coriolan-v/Mycelium-driver/Hardware/PCB/NEST Mushroom PCB Mk.1 pinout.pdf

# Mk.I NEST MAY 2023

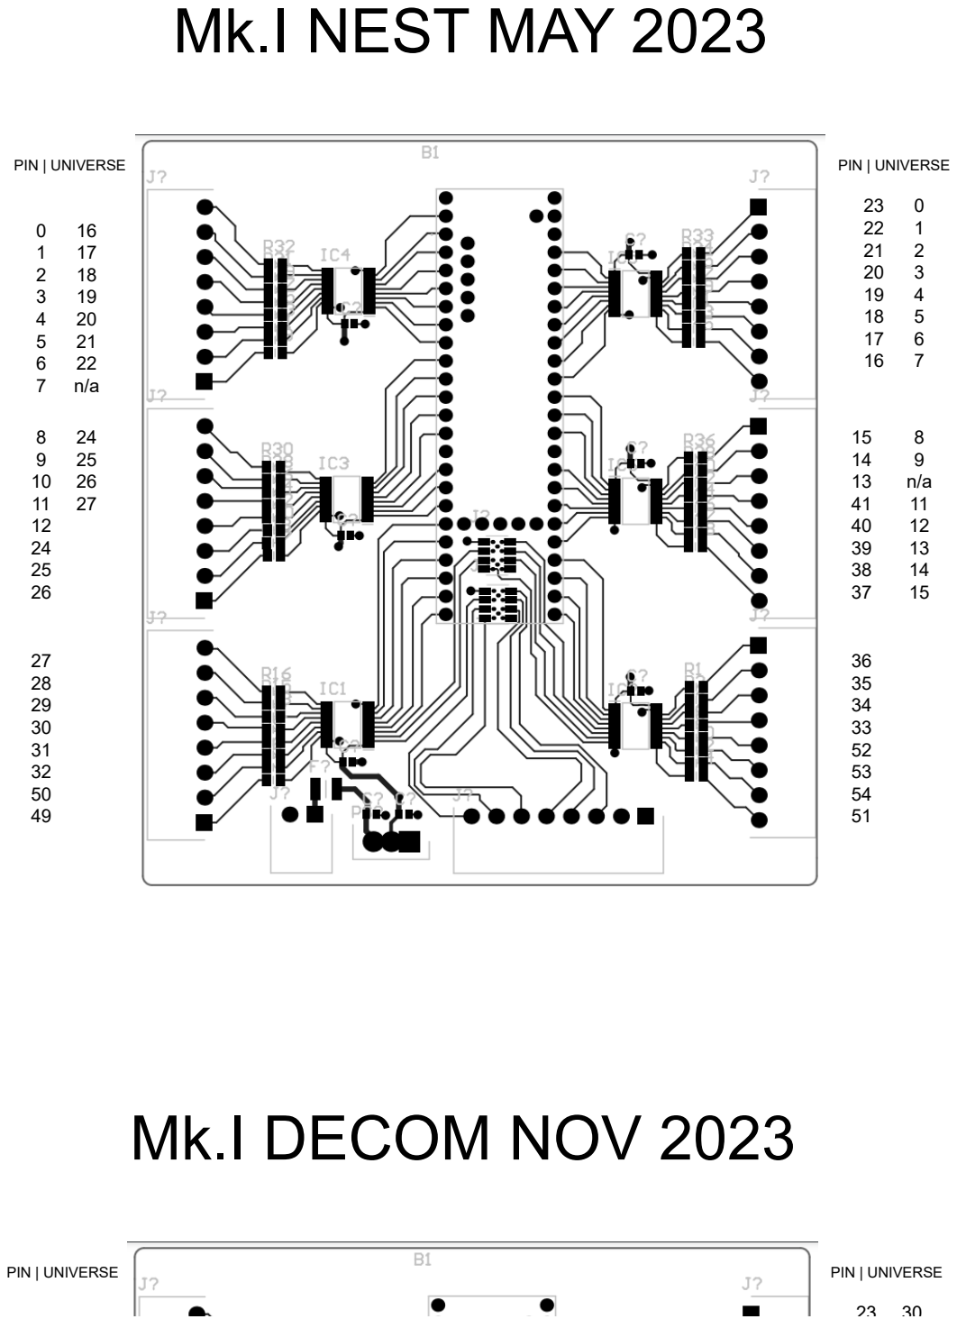
[picture p3: page 1]

PIN | UNIVERSE

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
PIN | UNIVERSE
PIN | UNIVERSE

23 30

PIN | UNIVERSE

# Mk.I DECOM NOV 2023

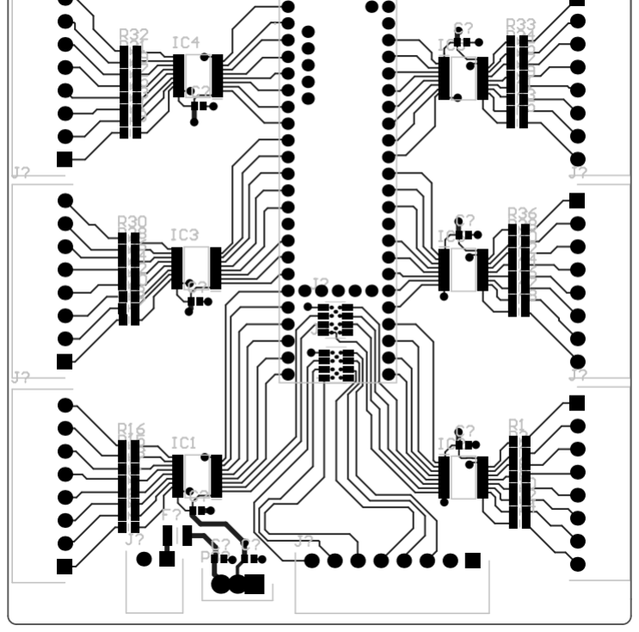
[picture p4: figure]

0123456789

1011

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
0123456789

1011

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
