coriolan-v/Mycelium-driver/Hardware/holder-1.stl

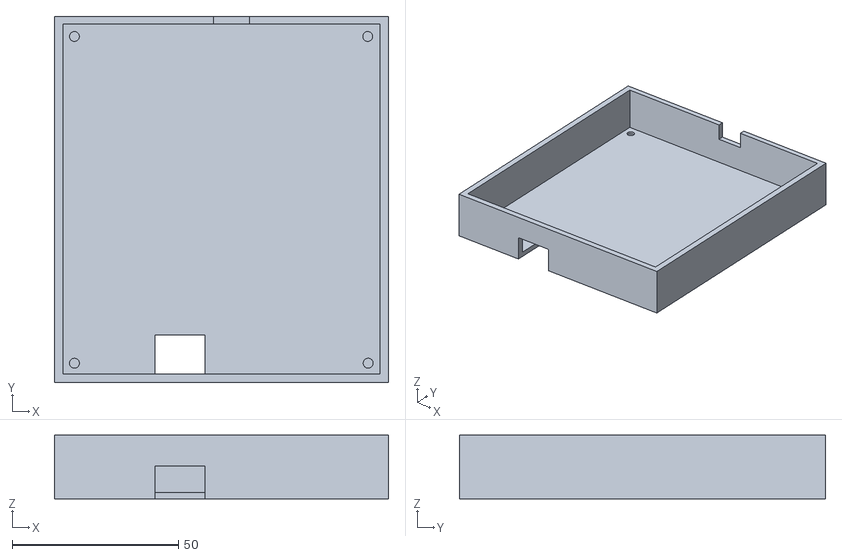
[picture p5: CAD file, 2026-06-23]
Hardware/holder-1.stl
100.7 x 110.2 x 19.2
