coriolan-v/Mycelium-driver/Hardware/cap-2.stl

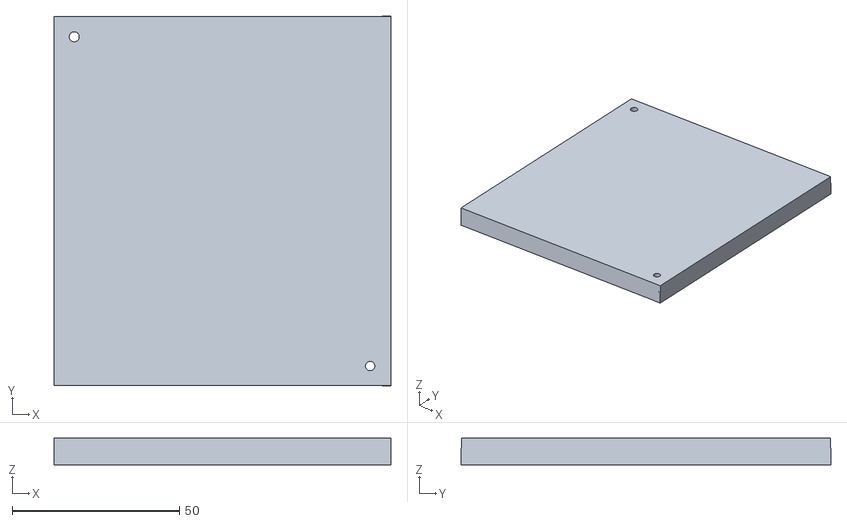
[picture p6: CAD file, 2026-06-23]
Hardware/cap-2.stl
100.7 x 110.5 x 7.98
