coriolan-v/Mycelium-driver/Hardware/cap-1.stl

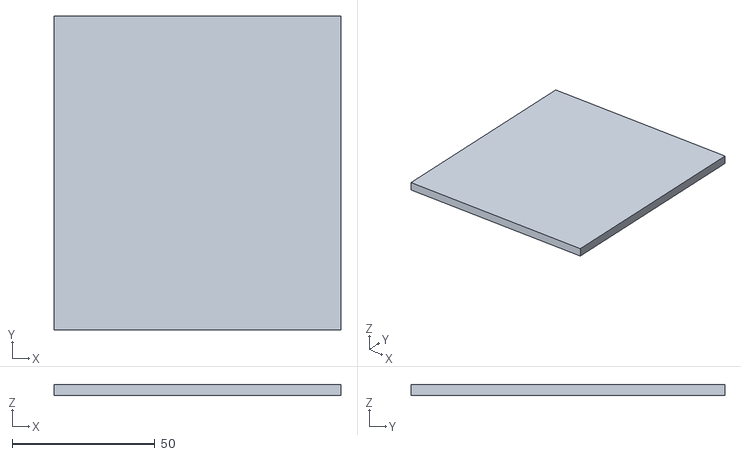
[picture p7: CAD file, 2026-06-23]
Hardware/cap-1.stl
100.7 x 110.2 x 4.00
