coriolan-v/Mycelium-driver/Hardware/holder-2.stl

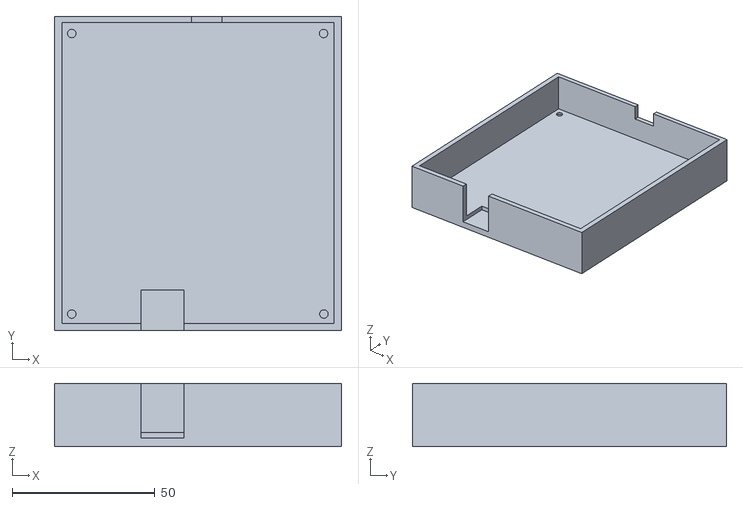
[picture p8: CAD file, 2026-06-23]
Hardware/holder-2.stl
100.7 x 110.2 x 22.2
