coriolan-v/Mycelium-driver/Hardware/PCB/pcb-outline.pdf

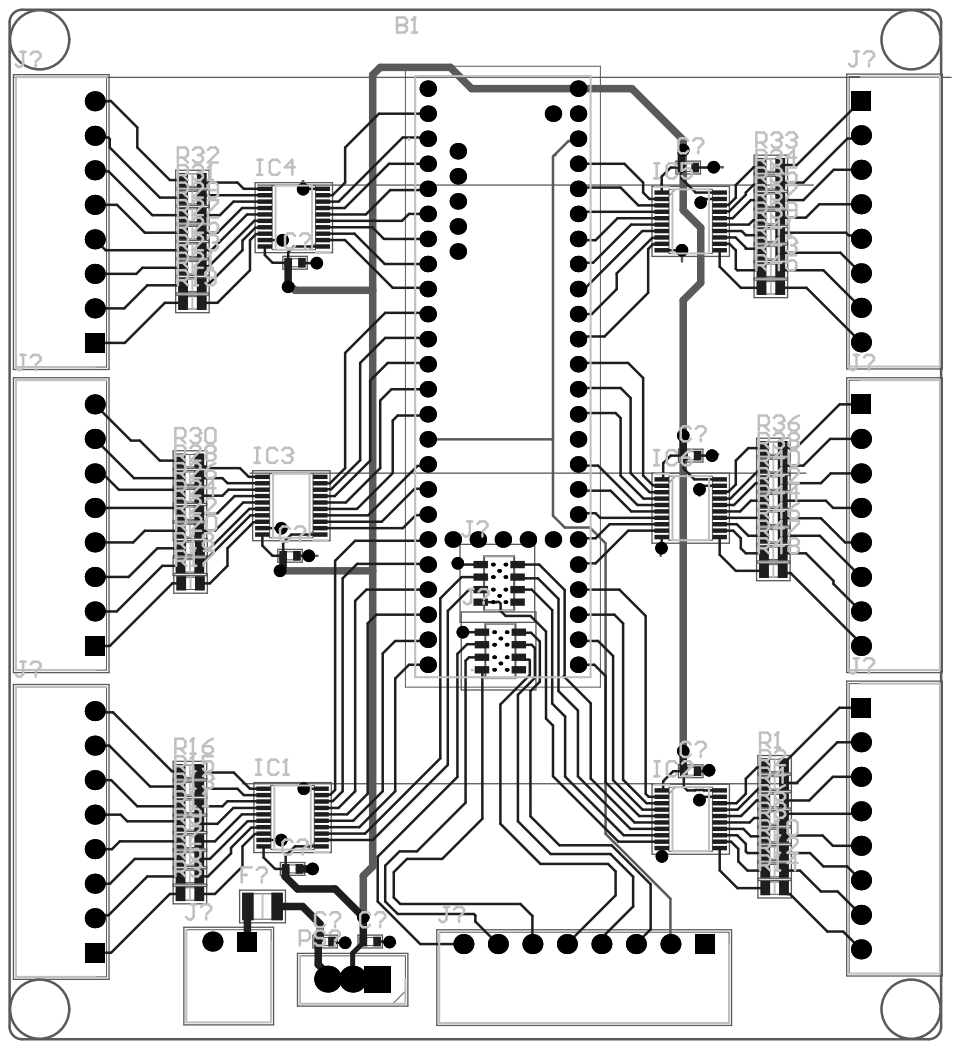
[picture p9: page 1]
