coriolan-v/Mycelium-driver/Hardware/PCB/Nest-Distrib-Mk.I/Nest-Distrib-MkI-Layout.pdf

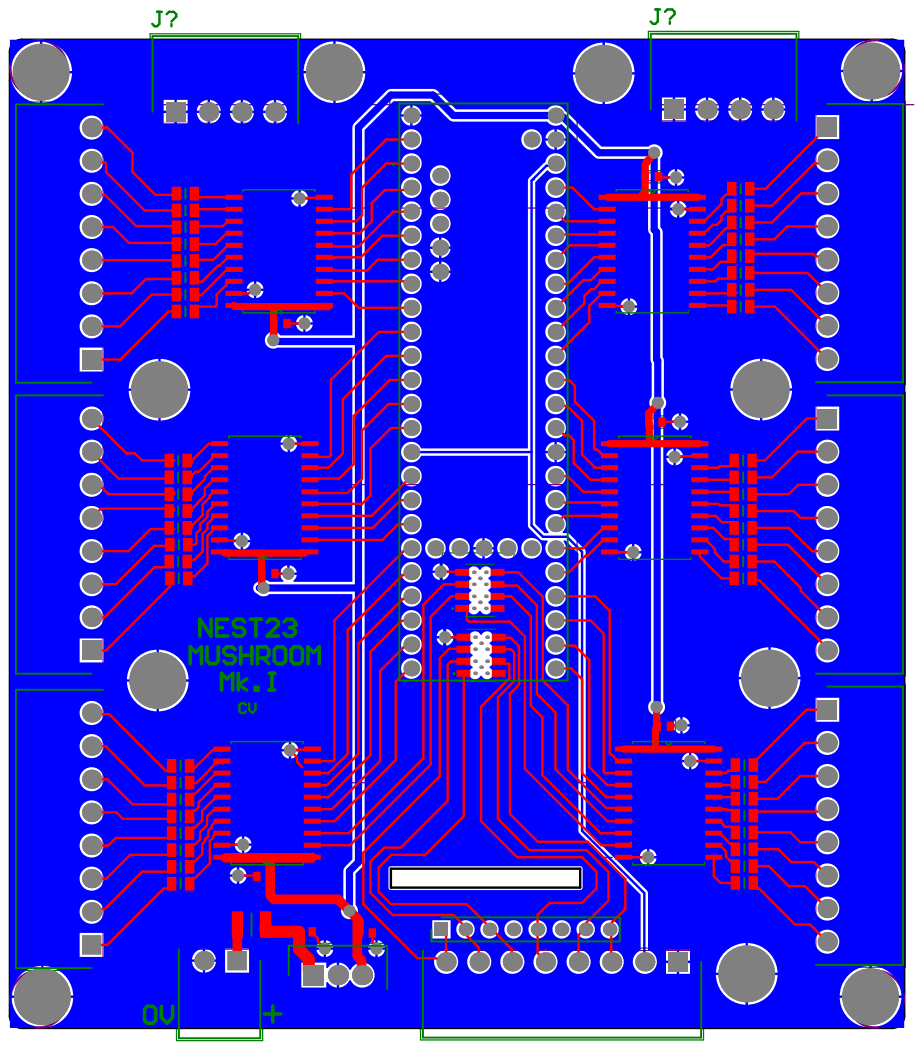
[picture p10: page 1]
