coriolan-v/Mycelium-driver/Hardware/PCB/Nest-Distrib-Mk.I/Nest-Distrib-MkI-Schematic.pdf

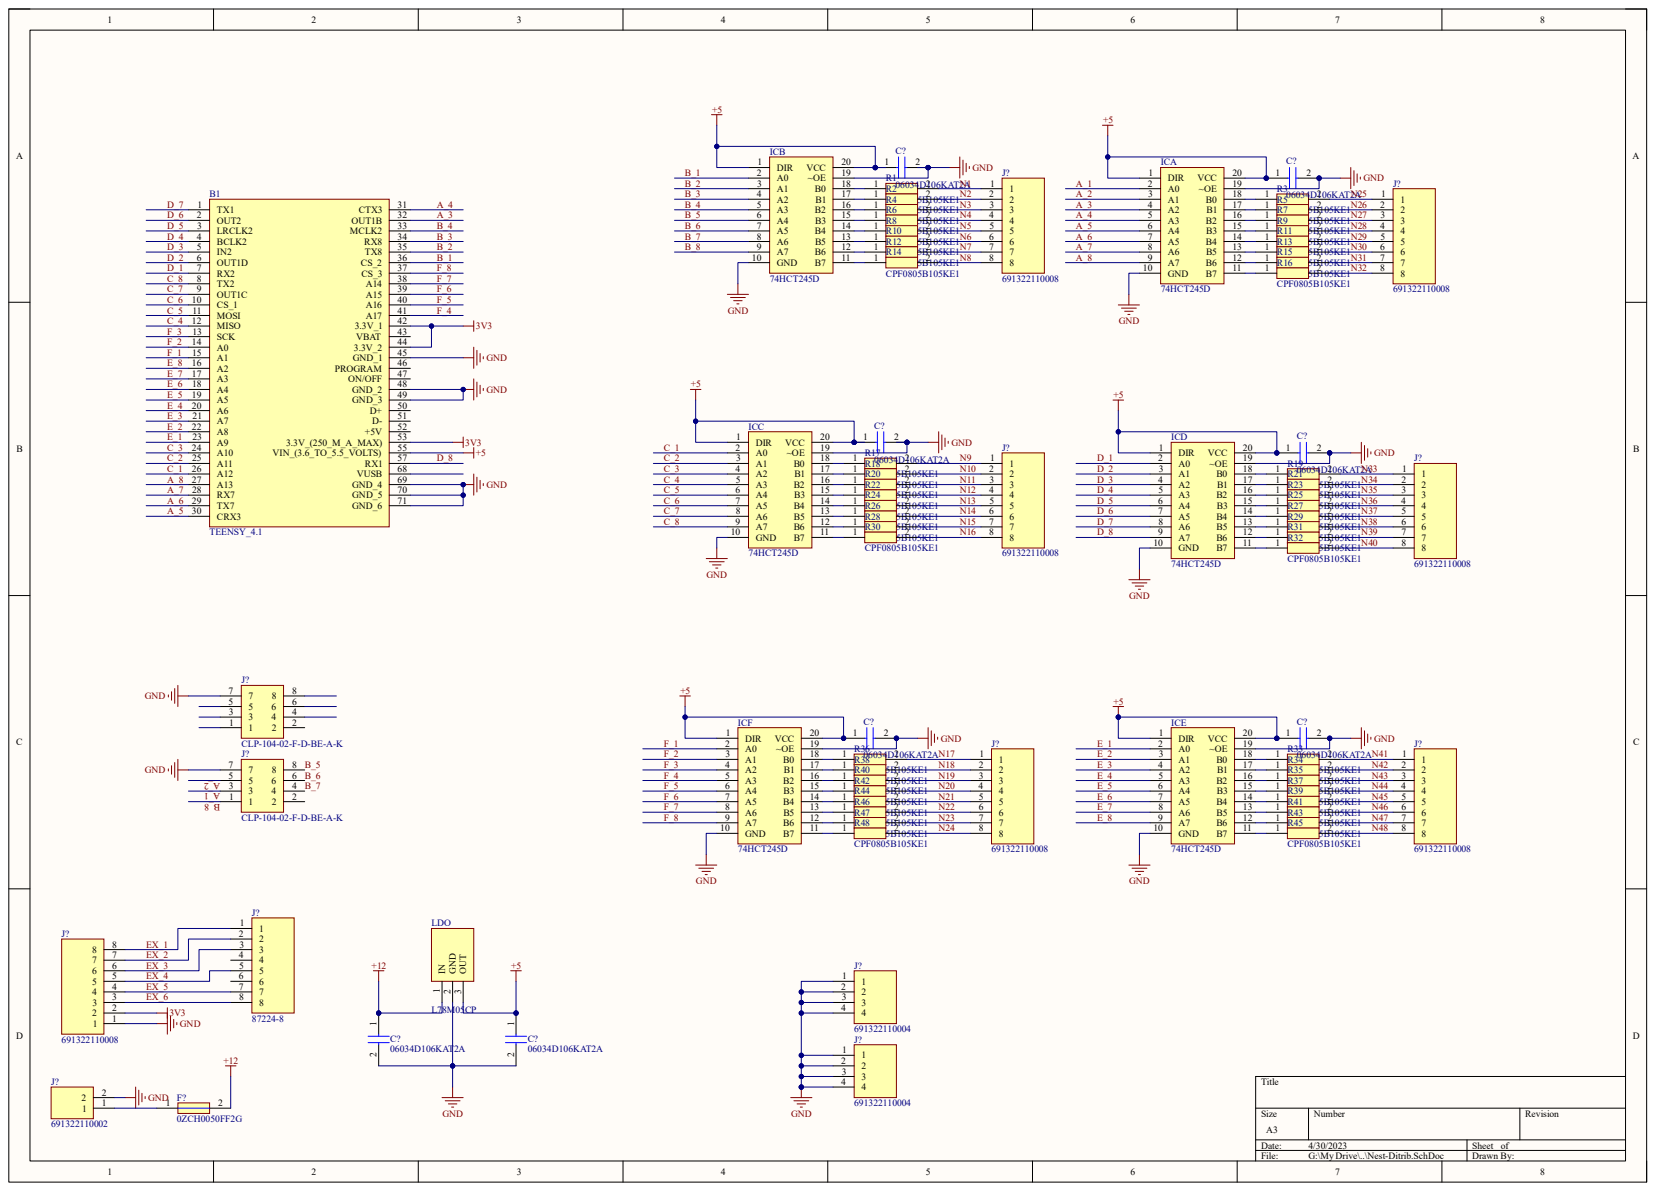
[picture p11: page 1]
