coriolan-v/Mycelium-driver/Hardware/PCB/Nest-Distrib-Mk.I/PCB1.pdf

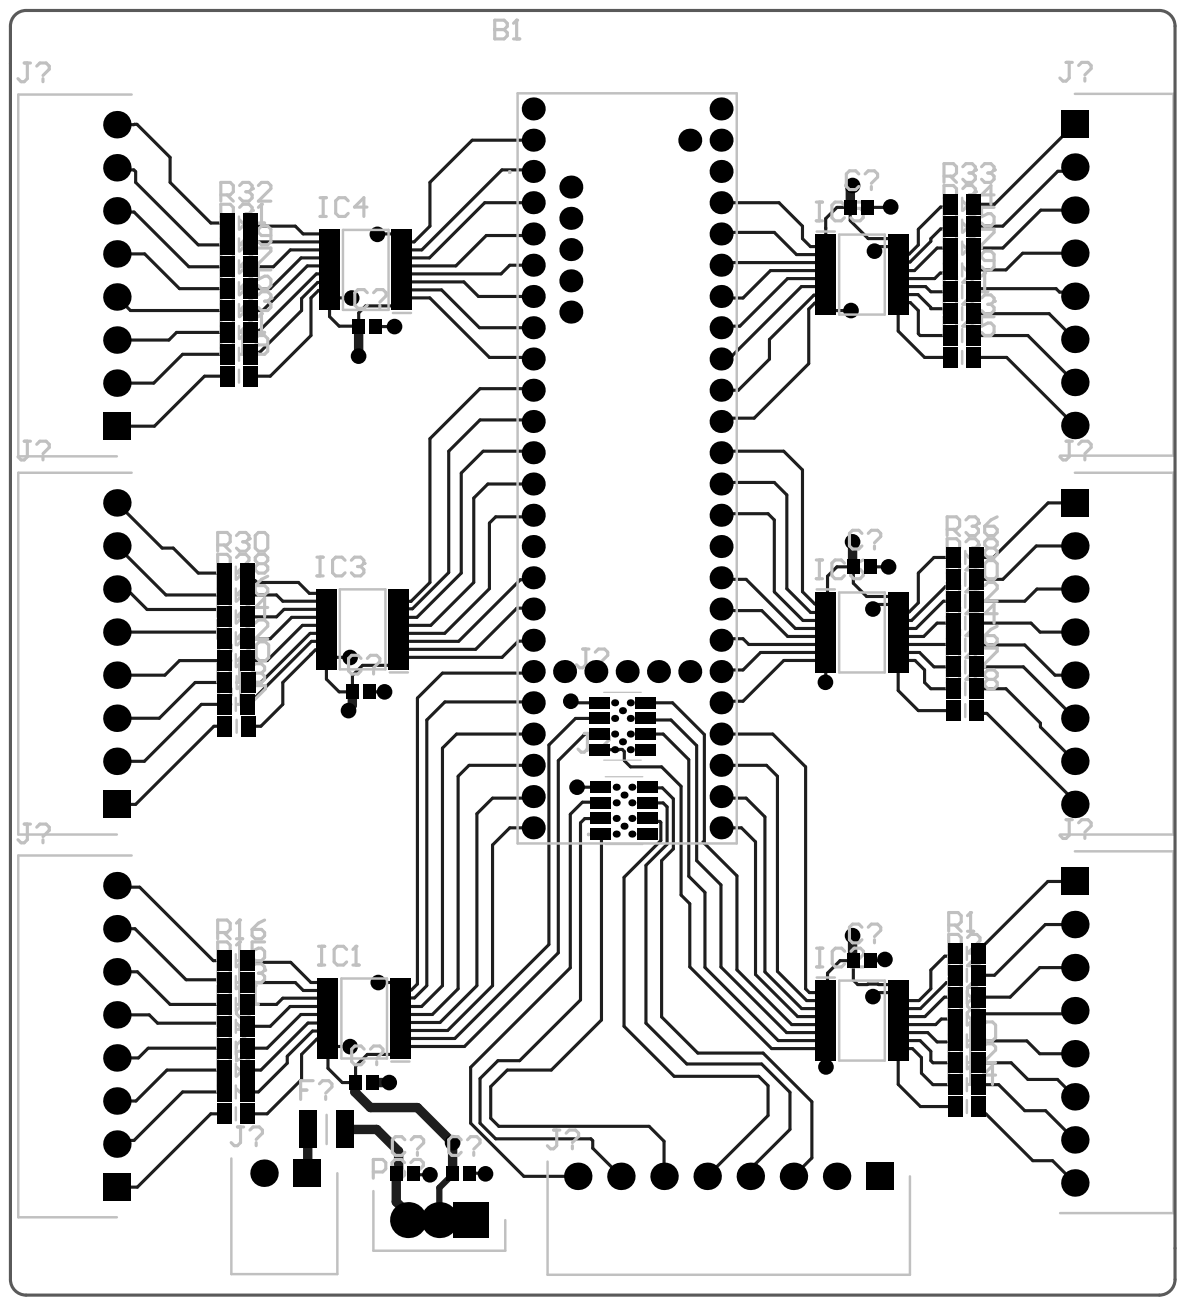
[picture p12: page 1]
