coriolan-v/Mycelium-driver/(list of files, drawings)

Other design files:
Hardware/PCB/Nest-Distrib-Mk.I/Nest-Distrib-Mk.I.PrjPcb
Hardware/PCB/Nest-Distrib-Mk.I/Nest-Ditrib.SchDoc
