coriolan-v/Mycelium-driver/(commit log)

2023-04-19 updated code to work on all LEDs. Still working on universe addressing issues
    [ArtNetWS2812_3.ino, OctoWS2811-Artnet.ino, Teensy4_PinList.ino]
2023-04-26 added master pcb tester and cleaned
2023-05-08 Updating LEDs fps
2023-10-02 Added HW, cleanded FW repo
    [Nest-Distrib-Mk.I.PrjPcb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]
2023-10-18 added Artnet to DMX + new stage for winch contrl
2023-11-08 adding stages
2024-04-06 saucer init content
    [Nest-Distrib-Mk.I.PrjPcb]
